apuder/PocketTRS/kicad/v2.1/PocketTRS.kicad_pcb

## KiCad design kicad/v2.1/PocketTRS.kicad_pcb (2020-08-30, an earlier design)

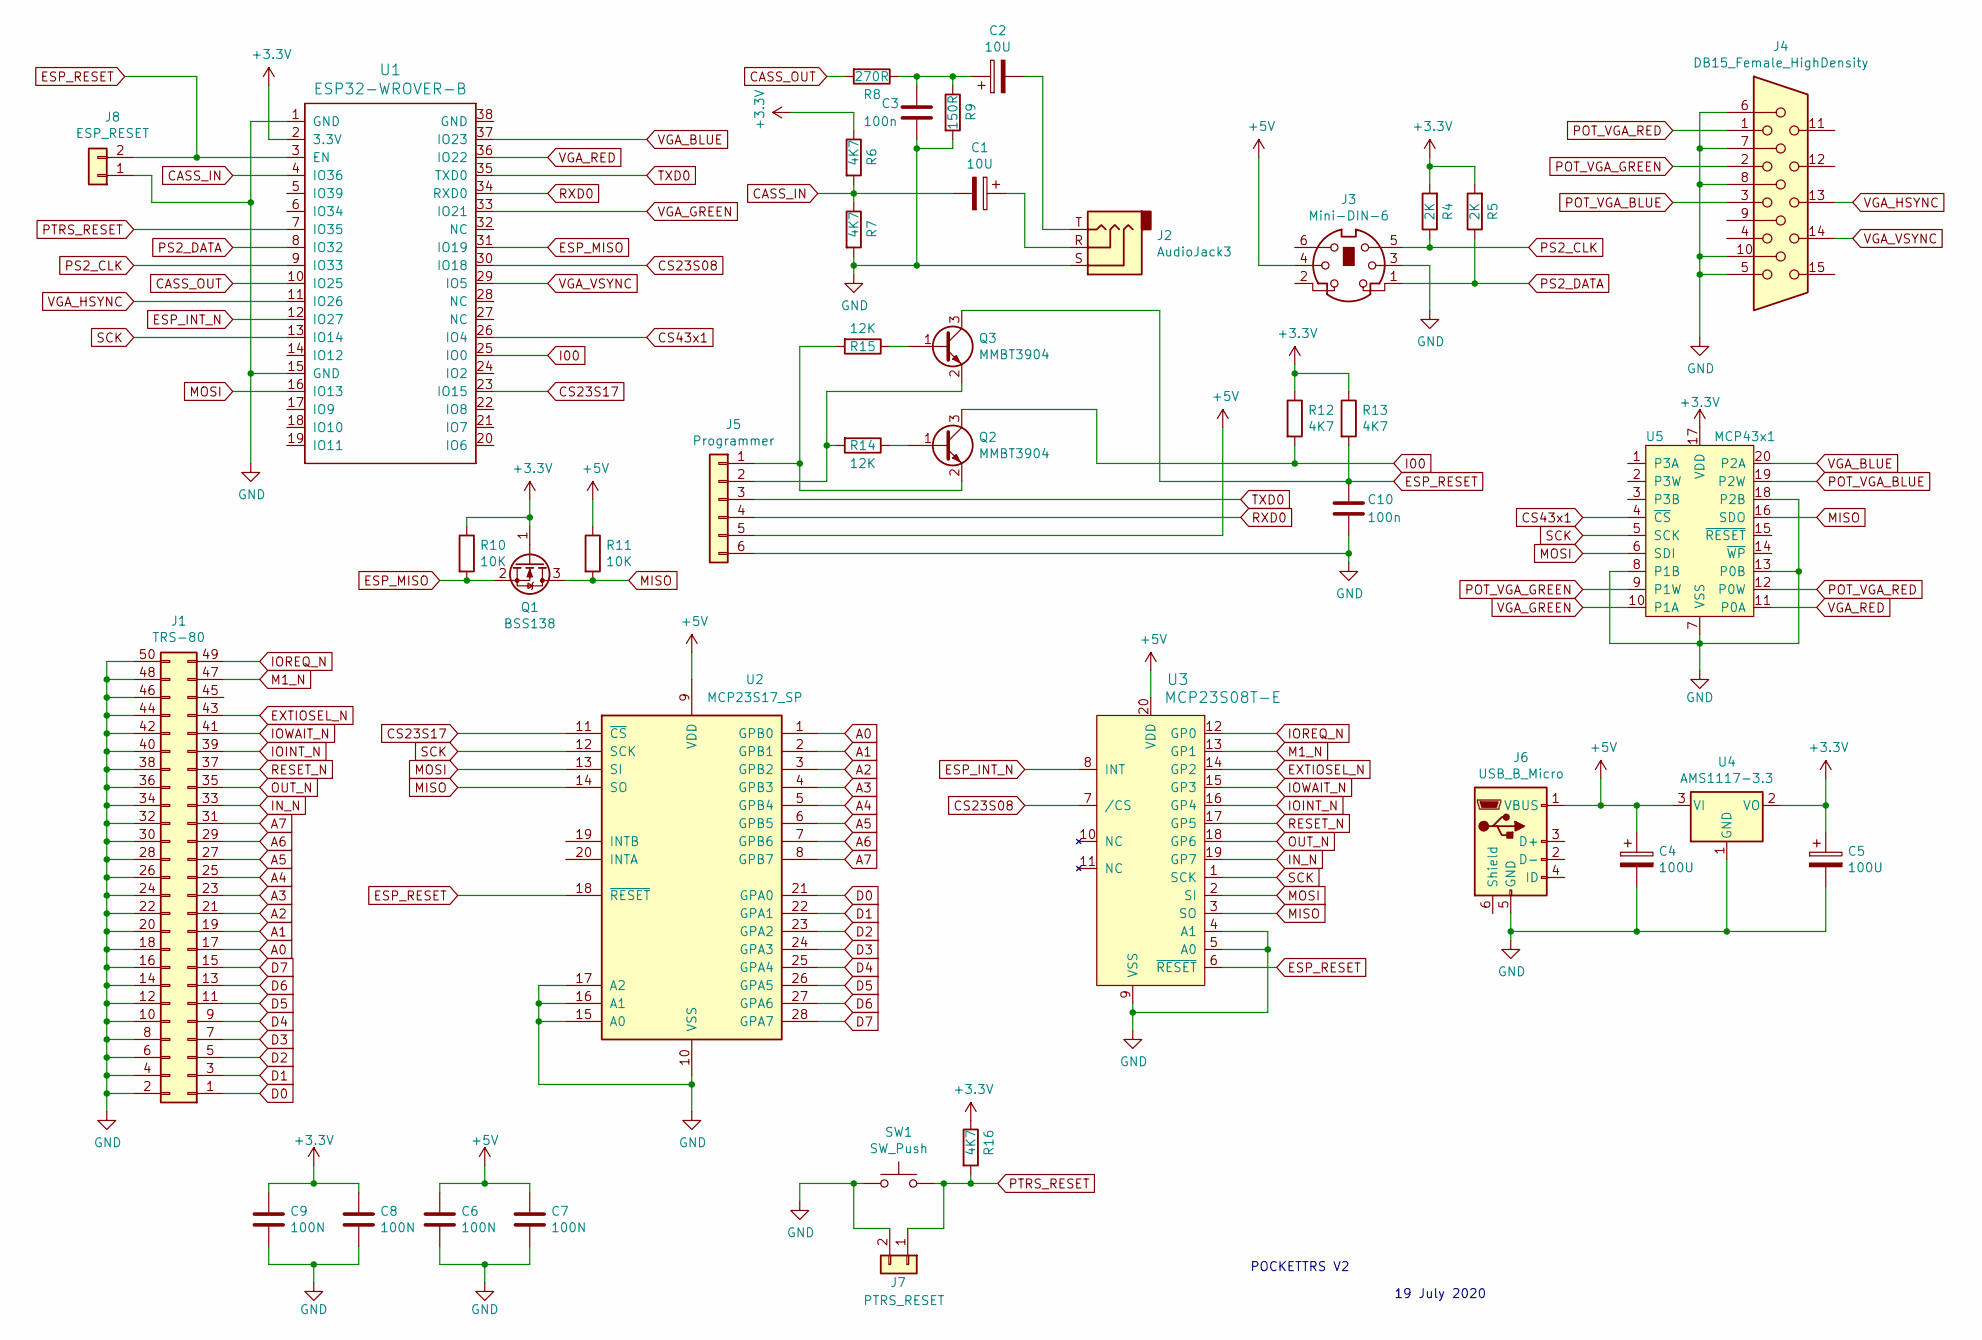
[picture p4: schematic PocketTRS.sch]

Parts:
C1, C2: 10U; C_1206_HandSoldering
C3, C10: 100n; C_0805_HandSoldering
C4, C5: 100U; C_1206_HandSoldering
C6, C7, C8, C9: 100N; C_0805_HandSoldering
J1: TRS-80; Pin_Header_Straight_2x25_Pitch2.54mm
J2: AudioJack3; Jack_3.5mm_CUI_SJ1-3535NG_Horizontal_CircularHoles
J3: Mini-DIN-6; minidin_6_ps2_pcb_mount
J4: DB15_Female_HighDensity; DB_15F-VGA
J5: Programmer; Pin_Header_Straight_1x06_Pitch2.54mm
J6: USB_B_Micro; USBmicro-B
J7: PTRS_RESET; Pin_Header_Straight_1x02_Pitch2.54mm
J8: ESP_RESET; Pin_Header_Straight_1x02_Pitch2.54mm
Q1: BSS138; SOT-23
Q2, Q3: MMBT3904; SOT-23
R4, R5: 2K; R_0805_HandSoldering
R6, R7, R12, R13, R16: 4K7; R_0805_HandSoldering
R8: 270R; R_0805_HandSoldering
R9: 150R; R_0805_HandSoldering
R10, R11: 10K; R_0805_HandSoldering
R14, R15: 12K; R_0805_HandSoldering
SW1: SW_Push; SW_Tactile_SPST_Angled_PTS645Vx31-2LFS
U1: ESP32-WROVER-B; ESP32-WROVER
U2: MCP23S17_SP; SSOP-28_5.3x10.2mm_Pitch0.65mm
U3: MCP23S08T-E; SSOP-20_5.3x7.2mm_Pitch0.65mm
U4: AMS1117-3.3; SOT-223-3_TabPin2
U5: MCP43x1; TSSOP-20_4.4x6.5mm_Pitch0.65mm

Connections:
+3V3: C5.1, C8.1, C9.1, Q1.1 (G), R4.2, R5.2, R6.1, R10.1, R12.1, R13.1, R16.1, U1.2 (3.3V), U4.2 (VO), U5.17 (VDD)
+5V: C4.1, C6.1, C7.1, J3.4, J5.5, J6.1 (VBUS), R11.1, U2.9 (VDD), U3.20 (VDD), U4.3 (VI)
A0: J1.17, U2.1 (GPB0)
A1: J1.19, U2.2 (GPB1)
A2: J1.21, U2.3 (GPB2)
A3: J1.23, U2.4 (GPB3)
A4: J1.25, U2.5 (GPB4)
A5: J1.27, U2.6 (GPB5)
A6: J1.29, U2.7 (GPB6)
A7: J1.31, U2.8 (GPB7)
CASS_IN: C1.2, R6.2, R7.1, U1.4 (IO36)
CASS_OUT: R8.2, U1.10 (IO25)
CS23S08: U1.30 (IO18), U3.7 (/CS)
CS23S17: U1.23 (IO15), U2.11 (~CS~)
CS43x1: U1.26 (IO4), U5.4 (~CS)
D0: J1.1, U2.21 (GPA0)
D1: J1.3, U2.22 (GPA1)
D2: J1.5, U2.23 (GPA2)
D3: J1.7, U2.24 (GPA3)
D4: J1.9, U2.25 (GPA4)
D5: J1.11, U2.26 (GPA5)
D6: J1.13, U2.27 (GPA6)
D7: J1.15, U2.28 (GPA7)
ESP_INT_N: U1.12 (IO27), U3.8 (INT)
ESP_MISO: Q1.2 (S), R10.2, U1.31 (IO19)
ESP_RESET: C10.1, J8.2, Q3.3 (C), R13.2, U1.3 (EN), U2.18 (~RESET~), U3.6 (~RESET)
EXTIOSEL_N: J1.43, U3.14 (GP2)
GND: C3.2, C4.2, C5.2, C6.2, C7.2, C8.2, C9.2, C10.2, J1.2, J1.4, J1.6, J1.8, J1.10, J1.12, J1.14, J1.16, J1.18, J1.20, J1.22, J1.24, J1.26, J1.28, J1.30, J1.32, J1.34, J1.36, J1.38, J1.40, J1.42, J1.44, J1.46, J1.48, J1.50, J2.S, J3.3, J4.5, J4.6, J4.7, J4.8, J4.10, J5.6, J6.5 (GND), J7.2, J8.1, R7.2, R9.2, SW1.1, U1.1 (GND), U1.15 (GND), U2.10 (VSS), U2.15 (A0), U2.16 (A1), U2.17 (A2), U3.4 (A1), U3.5 (A0), U3.9 (VSS), U4.1 (GND), U5.7 (VSS), U5.8 (P1B), U5.13 (P0B), U5.18 (P2B)
I00: Q2.3 (C), R12.2, U1.25 (IO0)
IN_N: J1.33, U3.19 (GP7)
IOINT_N: J1.39, U3.16 (GP4)
IOREQ_N: J1.49, U3.12 (GP0)
IOWAIT_N: J1.41, U3.15 (GP3)
M1_N: J1.47, U3.13 (GP1)
MISO: Q1.3 (D), R11.2, U2.14 (SO), U3.3 (SO), U5.16 (SDO)
MOSI: U1.16 (IO13), U2.13 (SI), U3.2 (SI), U5.6 (SDI)
unnamed: C1.1, J2.R
unnamed: C2.1, C3.1, R8.1, R9.1
unnamed: C2.2, J2.T
unnamed: J5.1, Q2.2 (E), R15.2
unnamed: J5.2, Q3.2 (E), R14.2
unnamed: Q2.1 (B), R14.1
unnamed: Q3.1 (B), R15.1
OUT_N: J1.35, U3.18 (GP6)
POT_VGA_BLUE: J4.3, U5.19 (P2W)
POT_VGA_GREEN: J4.2, U5.9 (P1W)
POT_VGA_RED: J4.1, U5.12 (P0W)
PS2_CLK: J3.5, R4.1, U1.9 (IO33)
PS2_DATA: J3.1, R5.1, U1.8 (IO32)
PTRS_RESET: J7.1, R16.2, SW1.2, U1.7 (IO35)
RESET_N: J1.37, U3.17 (GP5)
RXD0: J5.4, U1.34 (RXD0)
SCK: U1.13 (IO14), U2.12 (SCK), U3.1 (SCK), U5.5 (SCK)
TXD0: J5.3, U1.35 (TXD0)
VGA_BLUE: U1.37 (IO23), U5.20 (P2A)
VGA_GREEN: U1.33 (IO21), U5.10 (P1A)
VGA_HSYNC: J4.13, U1.11 (IO26)
VGA_RED: U1.36 (IO22), U5.11 (P0A)
VGA_VSYNC: J4.14, U1.29 (IO5)

Notes on the sheet:
POCKETTRS V2
19 July 2020

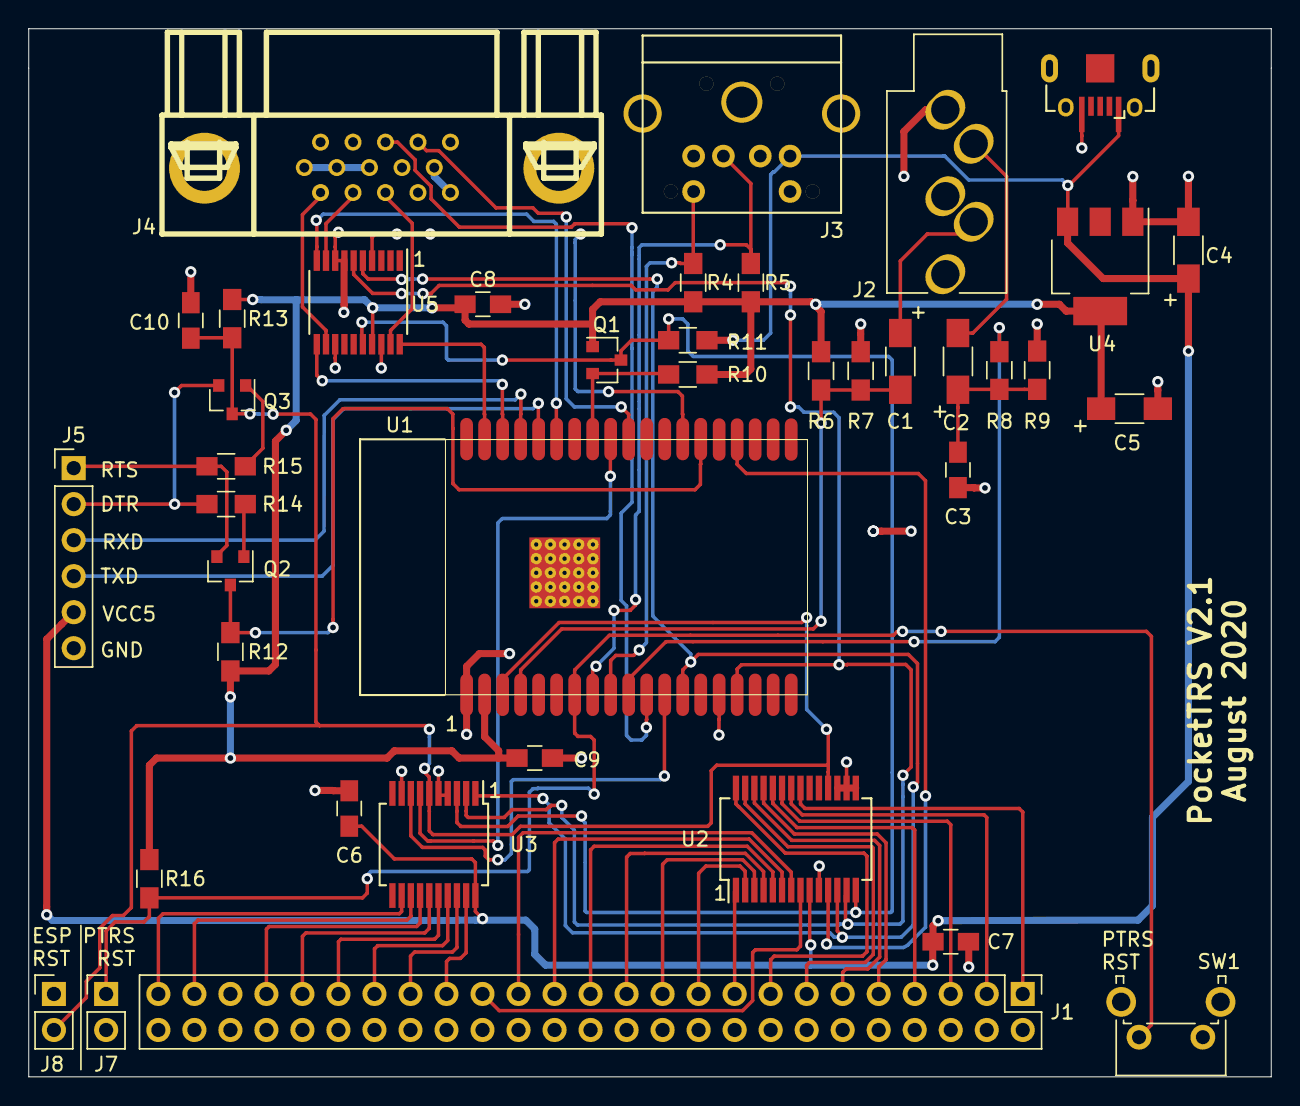
[picture p5: board kicad/v2.1/PocketTRS.kicad_pcb from above]

Board: 2 copper layers, 87.6 x 73.9 mm, 40 parts (0 on the bottom side), 59 nets.
